MrOnak/avr_DSKY/pictures/DSKY-7-seg-assembly.jpg

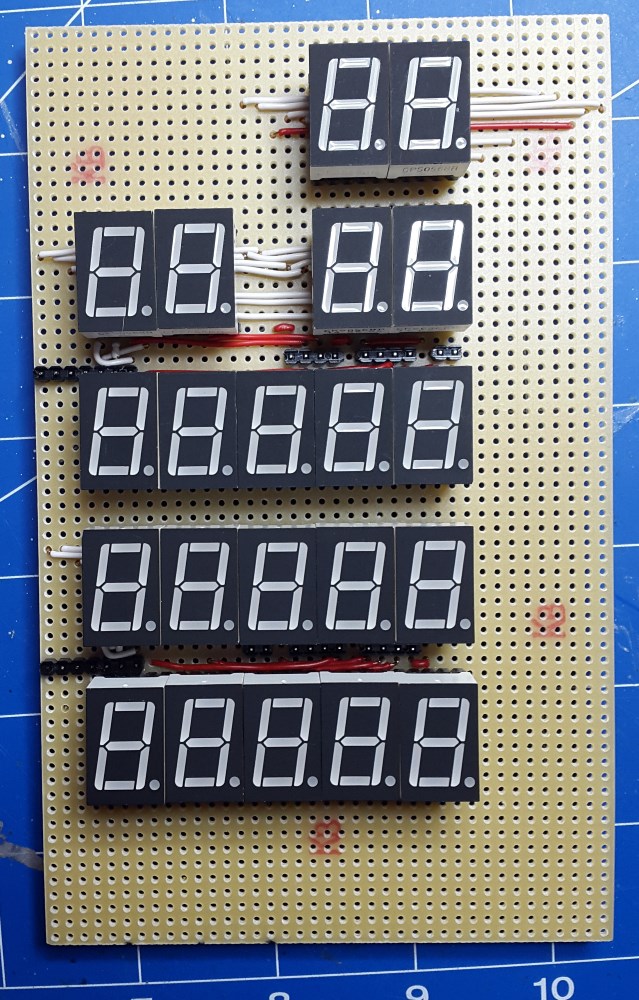
pictures/DSKY-7-seg-assembly.jpg
