MrOnak/avr_DSKY/pictures/DSKY-7-seg-front.jpg

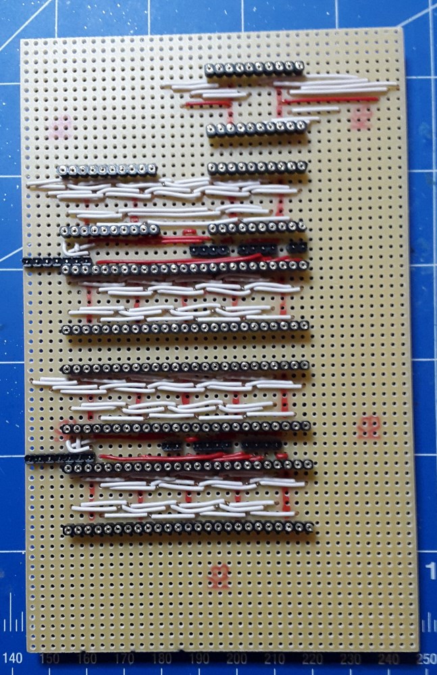
pictures/DSKY-7-seg-front.jpg
