MrOnak/avr_DSKY/EAGLE/DSKY_control_circuitry.png

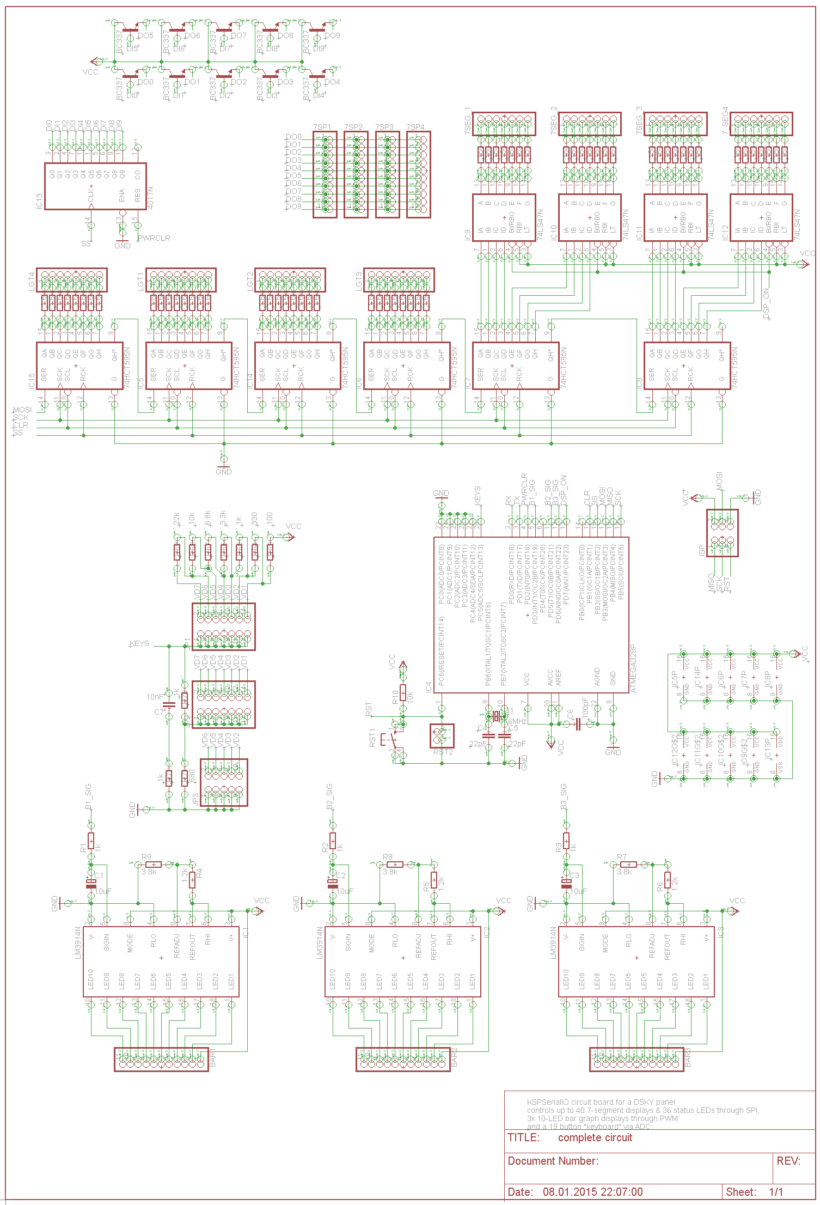
EAGLE/DSKY_control_circuitry.png
