MrOnak/avr_DSKY/EAGLE/joysticks_keyboard.png

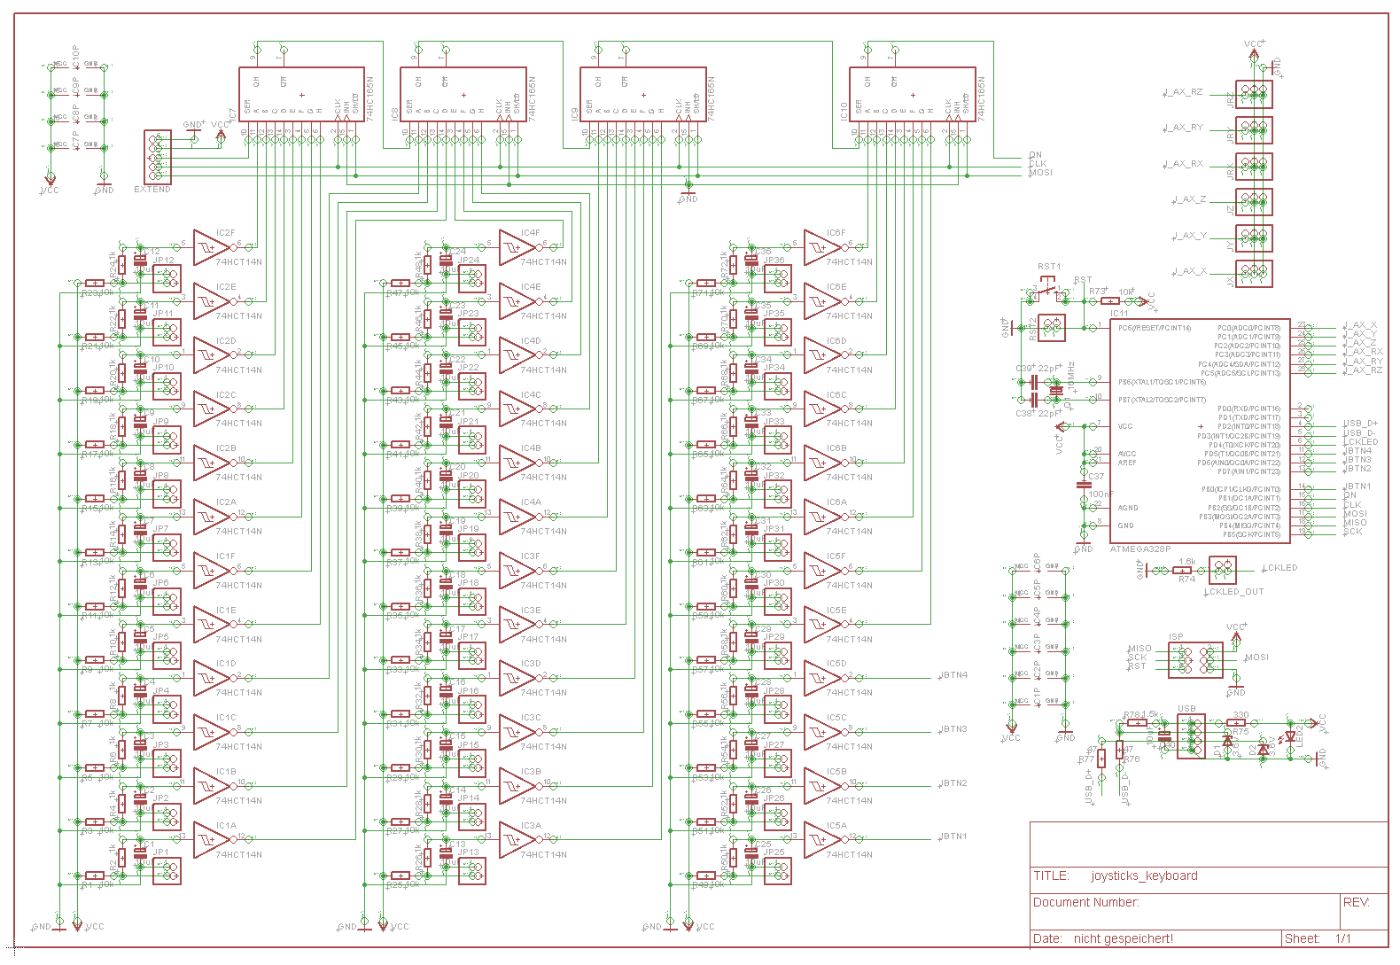
EAGLE/joysticks_keyboard.png
