MrOnak/avr_DSKY/pictures/DSKY-7-seg-back.jpg

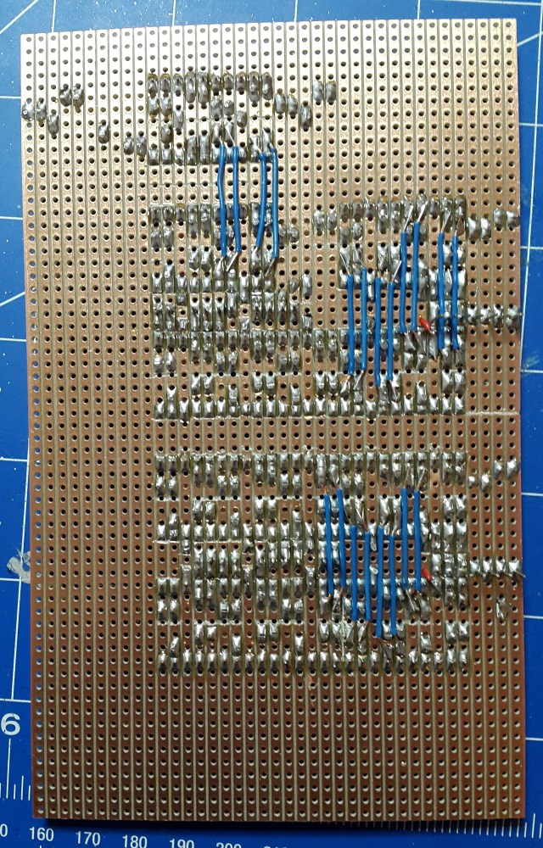
pictures/DSKY-7-seg-back.jpg
