MrOnak/avr_DSKY/EAGLE/DSKY_control_circuitry.sch

## EAGLE design EAGLE/DSKY_control_circuitry.sch (2015-01-08)

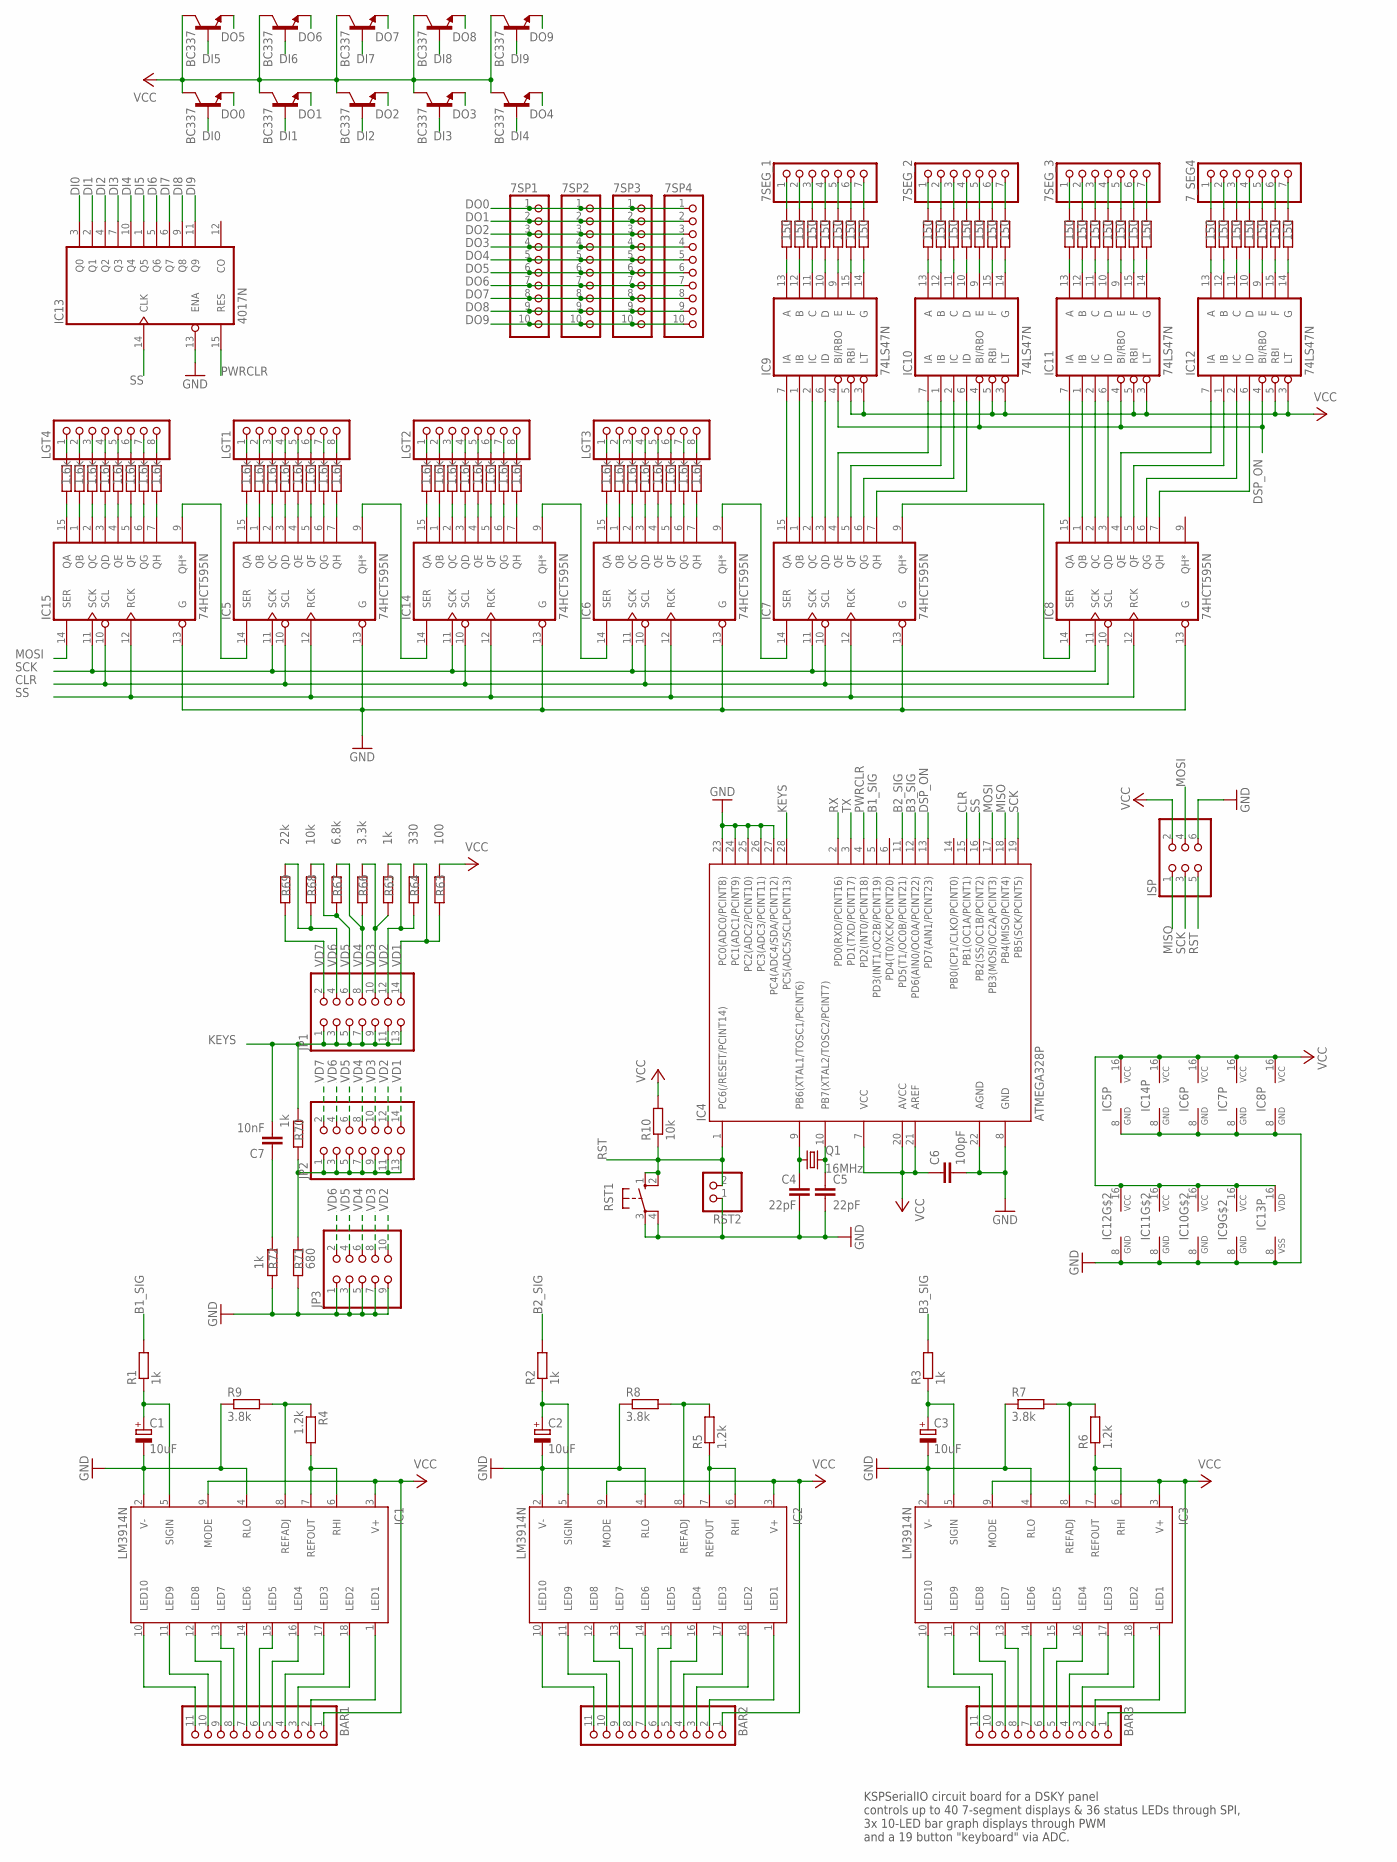
[picture p6: schematic DSKY_control_circuitry.sch]

Parts:
7SEG_1, 7SEG_2, 7SEG_3, 7_SEG4: PINHD-1X7; 1X07
7SP1, 7SP2, 7SP3, 7SP4: PINHD-1X10; 1X10
BAR1, BAR2, BAR3: PINHD-1X11; 1X11
C1, C2, C3: 10uF; E1,8-4
C4, C5: 22pF; C025-024X044
C6: 100pF; C025-024X044
C7: 10nF; C025-024X044
IC1, IC2, IC3: LM3914N; DIL18
IC4: ATMEGA328P; DIL28-3
IC5, IC6, IC7, IC8, IC14, IC15: 74HCT595N; DIL16
IC9, IC10, IC11, IC12: 74LS47N; DIL16
IC13: 4017N; DIL16
ISP: PINHD-2X3; 2X03
JP1, JP2: PINHD-2X7; 2X07
JP3: PINHD-2X5; 2X05
LGT1, LGT2, LGT3, LGT4: PINHD-1X8; 1X08
Q1: 16MHz; HC49/S
Q2, Q3, Q4, Q5, Q6, Q7, Q8, Q9, Q10, Q11: BC337; TO92
R1, R2, R3, R65, R70, R72: 1k; 0204V
R4, R5, R6: 1.2k; 0204V
R7, R8, R9: 3.8k; 0204V
R10, R68: 10k; 0204V
R11, R12, R13, R14, R15, R16, R17, R18, R19, R20, R21, R22, R23, R24, R25, R26, R27, R28, R29, R30, R31, R32, R33, R34, R35, R36, R37, R38: 150; 0204V
R39, R40, R41, R42, R43, R44, R45, R46, R47, R48, R49, R50, R51, R52, R53, R54, R55, R56, R57, R58, R59, R60, R61, R62, R73, R74, R75, R76, R77, R78, R79, R80: 1.6k; 0204V
R63: 100; 0204V
R64: 330; 0204V
R66: 3.3k; 0204V
R67: 6.8k; 0204V
R69: 22k; 0204V
R71: 680; 0204V
RST1: 10-XX; B3F-10XX
RST2: PINHD-1X2; 1X02

Connections:
AASDASD: IC5.14 (SER), IC15.9 (QH*)
B1_SIG: IC4.5 (PD3(INT1/OC2B/PCINT19)), R1.2
B2_SIG: IC4.11 (PD5(T1/OC0B/PCINT21)), R2.2
B3_SIG: IC4.12 (PD6(AIN0/OC0A/PCINT22)), R3.2
CLR: IC4.15 (PB1(OC1A/PCINT1)), IC5.10 (SCL), IC6.10 (SCL), IC7.10 (SCL), IC8.10 (SCL), IC14.10 (SCL), IC15.10 (SCL)
DI0: IC13.3 (Q0), Q2.2 (B)
DI1: IC13.2 (Q1), Q3.2 (B)
DI2: IC13.4 (Q2), Q4.2 (B)
DI3: IC13.7 (Q3), Q5.2 (B)
DI4: IC13.10 (Q4), Q6.2 (B)
DI5: IC13.1 (Q5), Q7.2 (B)
DI6: IC13.5 (Q6), Q8.2 (B)
DI7: IC13.6 (Q7), Q9.2 (B)
DI8: IC13.9 (Q8), Q10.2 (B)
DI9: IC13.11 (Q9), Q11.2 (B)
DO0: 7SP1.1, 7SP2.1, 7SP3.1, 7SP4.1, Q2.1 (E)
DO1: 7SP1.2, 7SP2.2, 7SP3.2, 7SP4.2, Q3.1 (E)
DO2: 7SP1.3, 7SP2.3, 7SP3.3, 7SP4.3, Q4.1 (E)
DO3: 7SP1.4, 7SP2.4, 7SP3.4, 7SP4.4, Q5.1 (E)
DO4: 7SP1.5, 7SP2.5, 7SP3.5, 7SP4.5, Q6.1 (E)
DO5: 7SP1.6, 7SP2.6, 7SP3.6, 7SP4.6, Q7.1 (E)
DO6: 7SP1.7, 7SP2.7, 7SP3.7, 7SP4.7, Q8.1 (E)
DO7: 7SP1.8, 7SP2.8, 7SP3.8, 7SP4.8, Q9.1 (E)
DO8: 7SP1.9, 7SP2.9, 7SP3.9, 7SP4.9, Q10.1 (E)
DO9: 7SP1.10, 7SP2.10, 7SP3.10, 7SP4.10, Q11.1 (E)
DSP_ON: IC4.13 (PD7(AIN1/PCINT23)), IC9.4 (BI/RBO), IC10.4 (BI/RBO), IC11.4 (BI/RBO), IC12.4 (BI/RBO)
GND: C1.-, C2.-, C3.-, C4.2, C5.2, C6.2, IC1.2 (V-), IC1.4 (RLO), IC2.2 (V-), IC2.4 (RLO), IC3.2 (V-), IC3.4 (RLO), IC4.8 (GND), IC4.22 (AGND), IC4.23 (PC0(ADC0/PCINT8)), IC4.24 (PC1(ADC1/PCINT9)), IC4.25 (PC2(ADC2/PCINT10)), IC4.26 (PC3(ADC3/PCINT11)), IC4.27 (PC4(ADC4/SDA/PCINT12)), IC5.8 (GND), IC5.13 (G), IC6.8 (GND), IC6.13 (G), IC7.8 (GND), IC7.13 (G), IC8.8 (GND), IC8.13 (G), IC9.8 (GND), IC10.8 (GND), IC11.8 (GND), IC12.8 (GND), IC13.8 (VSS), IC13.13 (ENA), IC14.8 (GND), IC14.13 (G), IC15.13 (G), ISP.6, JP3.1, JP3.3, JP3.5, JP3.7, JP3.9, R7.1, R8.1, R9.1, R71.1, R72.1, RST1.3, RST1.4 (P1), RST2.1
KEYS: C7.2, IC4.28 (PC5(ADC5/SCLPCINT13)), JP1.1, JP1.3, JP1.5, JP1.7, JP1.9, JP1.11, JP1.13, R70.2
MISO: IC4.18 (PB4(MISO/PCINT4)), ISP.1
MOSI: IC4.17 (PB3(MOSI/OC2A/PCINT3)), IC15.14 (SER), ISP.4
unnamed: BAR1.11, IC1.10 (LED10)
unnamed: BAR1.10, IC1.11 (LED9)
unnamed: BAR1.9, IC1.12 (LED8)
unnamed: BAR1.8, IC1.13 (LED7)
unnamed: BAR1.7, IC1.14 (LED6)
unnamed: BAR1.6, IC1.15 (LED5)
unnamed: BAR1.5, IC1.16 (LED4)
unnamed: BAR1.4, IC1.17 (LED3)
unnamed: BAR1.3, IC1.18 (LED2)
unnamed: BAR1.2, IC1.1 (LED1)
unnamed: IC1.8 (REFADJ), R4.1, R9.2
unnamed: C1.+, IC1.5 (SIGIN), R1.1
unnamed: IC7.15 (QA), IC9.7 (IA)
unnamed: IC1.6 (RHI), IC1.7 (REFOUT), R4.2
unnamed: C4.1, IC4.9 (PB6(XTAL1/TOSC1/PCINT6)), Q1.1
unnamed: IC2.6 (RHI), IC2.7 (REFOUT), R5.1
unnamed: IC2.8 (REFADJ), R5.2, R8.2
unnamed: C2.+, IC2.5 (SIGIN), R2.1
unnamed: C5.1, IC4.10 (PB7(XTAL2/TOSC2/PCINT7)), Q1.2
unnamed: C3.+, IC3.5 (SIGIN), R3.1
unnamed: IC3.8 (REFADJ), R6.2, R7.2
unnamed: IC3.6 (RHI), IC3.7 (REFOUT), R6.1
unnamed: IC7.1 (QB), IC9.1 (IB)
unnamed: BAR3.7, IC3.14 (LED6)
unnamed: BAR3.8, IC3.13 (LED7)
unnamed: BAR3.9, IC3.12 (LED8)
unnamed: BAR3.10, IC3.11 (LED9)
unnamed: BAR3.11, IC3.10 (LED10)
unnamed: BAR3.6, IC3.15 (LED5)
unnamed: BAR3.5, IC3.16 (LED4)
unnamed: BAR3.4, IC3.17 (LED3)
unnamed: BAR3.3, IC3.18 (LED2)
unnamed: BAR3.2, IC3.1 (LED1)
unnamed: BAR2.7, IC2.14 (LED6)
unnamed: BAR2.6, IC2.15 (LED5)
unnamed: BAR2.5, IC2.16 (LED4)
unnamed: BAR2.4, IC2.17 (LED3)
unnamed: BAR2.3, IC2.18 (LED2)
unnamed: BAR2.2, IC2.1 (LED1)
unnamed: BAR2.8, IC2.13 (LED7)
unnamed: BAR2.9, IC2.12 (LED8)
unnamed: BAR2.10, IC2.11 (LED9)
unnamed: BAR2.11, IC2.10 (LED10)
unnamed: IC7.2 (QC), IC9.2 (IC)
unnamed: IC7.3 (QD), IC9.6 (ID)
unnamed: IC7.4 (QE), IC10.7 (IA)
unnamed: IC7.5 (QF), IC10.1 (IB)
unnamed: IC7.6 (QG), IC10.2 (IC)
unnamed: IC7.7 (QH), IC10.6 (ID)
unnamed: IC8.15 (QA), IC11.7 (IA)
unnamed: IC8.1 (QB), IC11.1 (IB)
unnamed: IC8.2 (QC), IC11.2 (IC)
unnamed: IC8.3 (QD), IC11.6 (ID)
unnamed: IC8.4 (QE), IC12.7 (IA)
unnamed: IC8.5 (QF), IC12.1 (IB)
unnamed: IC8.6 (QG), IC12.2 (IC)
unnamed: IC8.7 (QH), IC12.6 (ID)
unnamed: IC12.14 (G), R38.1
unnamed: IC12.15 (F), R37.1
unnamed: IC12.9 (E), R36.1
unnamed: IC12.10 (D), R35.1
unnamed: IC12.11 (C), R34.1
unnamed: IC12.12 (B), R33.1
unnamed: IC12.13 (A), R32.1
unnamed: IC11.14 (G), R31.1
unnamed: IC11.15 (F), R30.1
unnamed: IC11.9 (E), R29.1
unnamed: IC11.10 (D), R28.1
unnamed: IC11.11 (C), R27.1
unnamed: IC11.12 (B), R26.1
unnamed: IC11.13 (A), R25.1
unnamed: IC10.14 (G), R24.1
unnamed: IC10.15 (F), R23.1
unnamed: IC10.9 (E), R22.1
unnamed: IC10.10 (D), R21.1
unnamed: IC10.11 (C), R20.1
unnamed: IC10.12 (B), R19.1
unnamed: IC10.13 (A), R18.1
unnamed: 7SEG_2.1, R18.2
unnamed: 7SEG_2.2, R19.2
unnamed: 7SEG_2.3, R20.2
unnamed: 7SEG_2.4, R21.2
unnamed: 7SEG_2.5, R22.2
unnamed: 7SEG_2.6, R23.2
unnamed: 7SEG_2.7, R24.2
unnamed: IC6.14 (SER), IC14.9 (QH*)
unnamed: IC6.9 (QH*), IC7.14 (SER)
unnamed: IC7.9 (QH*), IC8.14 (SER)
unnamed: IC5.9 (QH*), IC14.14 (SER)
unnamed: 7SEG_3.1, R25.2
unnamed: 7SEG_3.2, R26.2
unnamed: 7SEG_3.3, R27.2
unnamed: 7SEG_3.4, R28.2
unnamed: 7SEG_3.5, R29.2
unnamed: 7SEG_3.6, R30.2
unnamed: 7SEG_3.7, R31.2
unnamed: 7_SEG4.1, R32.2
unnamed: 7_SEG4.2, R33.2
unnamed: 7_SEG4.3, R34.2
unnamed: 7_SEG4.4, R35.2
unnamed: 7_SEG4.5, R36.2
unnamed: 7_SEG4.6, R37.2
unnamed: 7_SEG4.7, R38.2
unnamed: IC9.14 (G), R17.1
unnamed: IC9.15 (F), R16.1
unnamed: IC9.9 (E), R15.1
unnamed: IC9.10 (D), R14.1
unnamed: IC9.11 (C), R13.1
unnamed: IC9.12 (B), R12.1
unnamed: IC9.13 (A), R11.1
unnamed: 7SEG_1.1, R11.2
unnamed: 7SEG_1.2, R12.2
unnamed: 7SEG_1.3, R13.2
unnamed: 7SEG_1.4, R14.2
unnamed: 7SEG_1.5, R15.2
unnamed: 7SEG_1.6, R16.2
unnamed: 7SEG_1.7, R17.2
unnamed: IC5.15 (QA), R39.1
unnamed: IC5.1 (QB), R40.1
unnamed: IC5.2 (QC), R41.1
unnamed: IC5.3 (QD), R42.1
unnamed: IC5.4 (QE), R43.1
unnamed: IC5.5 (QF), R44.1
unnamed: IC5.6 (QG), R45.1
unnamed: IC5.7 (QH), R46.1
unnamed: IC14.15 (QA), R47.1
unnamed: IC14.1 (QB), R48.1
unnamed: IC14.2 (QC), R49.1
unnamed: IC14.3 (QD), R50.1
unnamed: IC14.4 (QE), R51.1
unnamed: IC14.5 (QF), R52.1
unnamed: IC14.6 (QG), R53.1
unnamed: IC14.7 (QH), R54.1
unnamed: IC6.15 (QA), R55.1
unnamed: IC6.1 (QB), R56.1
unnamed: IC6.2 (QC), R57.1
unnamed: IC6.3 (QD), R58.1
unnamed: IC6.4 (QE), R59.1
unnamed: IC6.5 (QF), R60.1
unnamed: IC6.6 (QG), R61.1
unnamed: IC6.7 (QH), R62.1
unnamed: LGT3.8, R62.2
unnamed: LGT3.7, R61.2
unnamed: LGT3.6, R60.2
unnamed: LGT3.5, R59.2
unnamed: LGT3.4, R58.2
unnamed: LGT3.3, R57.2
unnamed: LGT3.2, R56.2
unnamed: LGT3.1, R55.2
unnamed: LGT2.8, R54.2
unnamed: LGT2.7, R53.2
unnamed: LGT2.6, R52.2
unnamed: LGT2.5, R51.2
unnamed: LGT2.4, R50.2
unnamed: LGT2.3, R49.2
unnamed: LGT2.2, R48.2
unnamed: LGT2.1, R47.2
unnamed: LGT1.8, R46.2
unnamed: LGT1.7, R45.2
unnamed: LGT1.6, R44.2
unnamed: LGT1.5, R43.2
unnamed: LGT1.4, R42.2
unnamed: LGT1.3, R41.2
unnamed: LGT1.2, R40.2
unnamed: LGT1.1, R39.2
unnamed: IC15.15 (QA), R73.1
unnamed: JP2.1, JP2.3, JP2.5, JP2.7, JP2.9, JP2.11, JP2.13, R70.1, R71.2
unnamed: IC15.1 (QB), R74.1
unnamed: IC15.2 (QC), R75.1
unnamed: C7.1, R72.2
unnamed: IC15.3 (QD), R76.1
unnamed: IC15.4 (QE), R77.1
unnamed: IC15.5 (QF), R78.1
unnamed: IC15.6 (QG), R79.1
unnamed: IC15.7 (QH), R80.1
unnamed: LGT4.8, R80.2
unnamed: LGT4.7, R79.2
unnamed: LGT4.6, R78.2
unnamed: LGT4.5, R77.2
unnamed: LGT4.4, R76.2
unnamed: LGT4.3, R75.2
unnamed: LGT4.2, R74.2
unnamed: LGT4.1, R73.2
PWRCLR: IC4.4 (PD2(INT0/PCINT18)), IC13.15 (RES)
RST: IC4.1 (PC6(/RESET/PCINT14)), ISP.5, R10.1, RST1.1 (S), RST1.2 (S1), RST2.2
RX: IC4.2 (PD0(RXD/PCINT16))
SCK: IC4.19 (PB5(SCK/PCINT5)), IC5.11 (SCK), IC6.11 (SCK), IC7.11 (SCK), IC8.11 (SCK), IC14.11 (SCK), IC15.11 (SCK), ISP.3
SS: IC4.16 (PB2(SS/OC1B/PCINT2)), IC5.12 (RCK), IC6.12 (RCK), IC7.12 (RCK), IC8.12 (RCK), IC13.14 (CLK), IC14.12 (RCK), IC15.12 (RCK)
TX: IC4.3 (PD1(TXD/PCINT17))
VCC: BAR1.1, BAR2.1, BAR3.1, C6.1, IC1.3 (V+), IC1.9 (MODE), IC2.3 (V+), IC2.9 (MODE), IC3.3 (V+), IC3.9 (MODE), IC4.7 (VCC), IC4.20 (AVCC), IC4.21 (AREF), IC5.16 (VCC), IC6.16 (VCC), IC7.16 (VCC), IC8.16 (VCC), IC9.3 (LT), IC9.5 (RBI), IC9.16 (VCC), IC10.3 (LT), IC10.5 (RBI), IC10.16 (VCC), IC11.3 (LT), IC11.5 (RBI), IC11.16 (VCC), IC12.3 (LT), IC12.5 (RBI), IC12.16 (VCC), IC13.16 (VDD), IC14.16 (VCC), ISP.2, Q2.3 (C), Q3.3 (C), Q4.3 (C), Q5.3 (C), Q6.3 (C), Q7.3 (C), Q8.3 (C), Q9.3 (C), Q10.3 (C), Q11.3 (C), R10.2, R63.2
VD1: JP1.14, JP2.14, R63.1, R64.2
VD2: JP1.12, JP2.12, JP3.10, R64.1, R65.2
VD3: JP1.10, JP2.10, JP3.8, R65.1, R66.2
VD4: JP1.8, JP2.8, JP3.6, R66.1, R67.2
VD5: JP1.6, JP2.6, JP3.4, R67.1, R68.2
VD6: JP1.4, JP2.4, JP3.2, R68.1, R69.2
VD7: JP1.2, JP2.2, R69.1

Notes on the sheet:
KSPSerialIO circuit board for a DSKY panel controls up to 40 7-segment displays & 36 status LEDs through SPI, 3x 10-LED bar graph displays through PWM and a 19 button "keyboard" via ADC.
