MrOnak/avr_DSKY/tests/7segs/config.h

#define DSKY_BARGRAPH_CTRL_PORT DDRD
#define DSKY_BARGRAPH_DATA_PORT PORTD
#define DSKY_BARGRAPH_PIN_B1 PD3
#define DSKY_BARGRAPH_PIN_B2 PD5
#define DSKY_BARGRAPH_PIN_B3 PD6

#define DSKY_DISPLAY_PIN_CLR PB1		// int sr_srclr    = 9;   // any free digital pin will do
#define DSKY_DISPLAY_PIN_PWRCLR PD2
