MrOnak/avr_DSKY/(commit log)

2014-10-08 reworked defines to reduce compiled size
    45995 -> 44265 byte
    - got rid of *valid* range-check arrays
    - refactored dsky_checkCommandIsValid to not use retval but return
    instantly
    - renumbered many defines to have non-interrupted sequences of define
    groups
    - introduced DSKY_MIN_* / DSKY_MAX_* range check defines
    - removed arrayPos16() and arrayPos8() since they were replaced with
    DSKY_MIN_* / DSKY_MAX_* range checks
    [dsky.c, dsky.h]
2014-10-08 added preliminary EAGLE files
    circutry is untested and incomplete
    [bargraph.sch, microcontroller.sch]
2014-10-08 reworked value range for bar graphs
    replaced 100% value with 0xFF since that's 100% duty cycle for PWM
    [dsky.c]
2014-10-09 added EAGLE file for multiplexing circuit
    [7seg multiplexer.sch]
2014-10-09 fixed infoLight shift registers
    infoLights now occupy shift registers 6 and 7.
    shift register 5 has 3 MSBs unutilized
    got rid of dskyDisplay_updateSingle() - now done in dskyDisplay_update()
    directly - oddly enough that increased the .hex size considerably
    [display.c, display.h]
2014-10-09 added VERB/NOUN info lights
    also combined a switch() statement in dsky_updateDisplayData() to save
    some space
2014-12-01 added INFOLIGHT constants for SAS, RCS, GEAR, BRK, LGT. changed displayDigits to 4 rows of 10 digits to support new circuitry with decade counter
2014-12-01 fixed typo in dskyDisplay_setValue(). updated CHANGELOG and TODOS
    [display.c]
2015-01-01 minor fixes on life code. mayor progress on tests
    [config.h, display.c, dsky.h, kspio.c, kspio.h, main.c, main.h, millis.c]
2015-01-01 changing 74595 related tests to interrupt driven update routine
2015-01-08 added tests for the keyboard ADC input and tweaked voltage level that maps the keys
2015-01-08 updated EAGLE files
    [7seg multiplexer.sch, DSKY_control_circuitry.sch, bargraph.sch, joysticks_keyboard.sch, microcontroller.sch]
